fkpwolf/tinyFan/Schematic/tinyfan.sch

## EAGLE design Schematic/tinyfan.sch (2012-07-02)

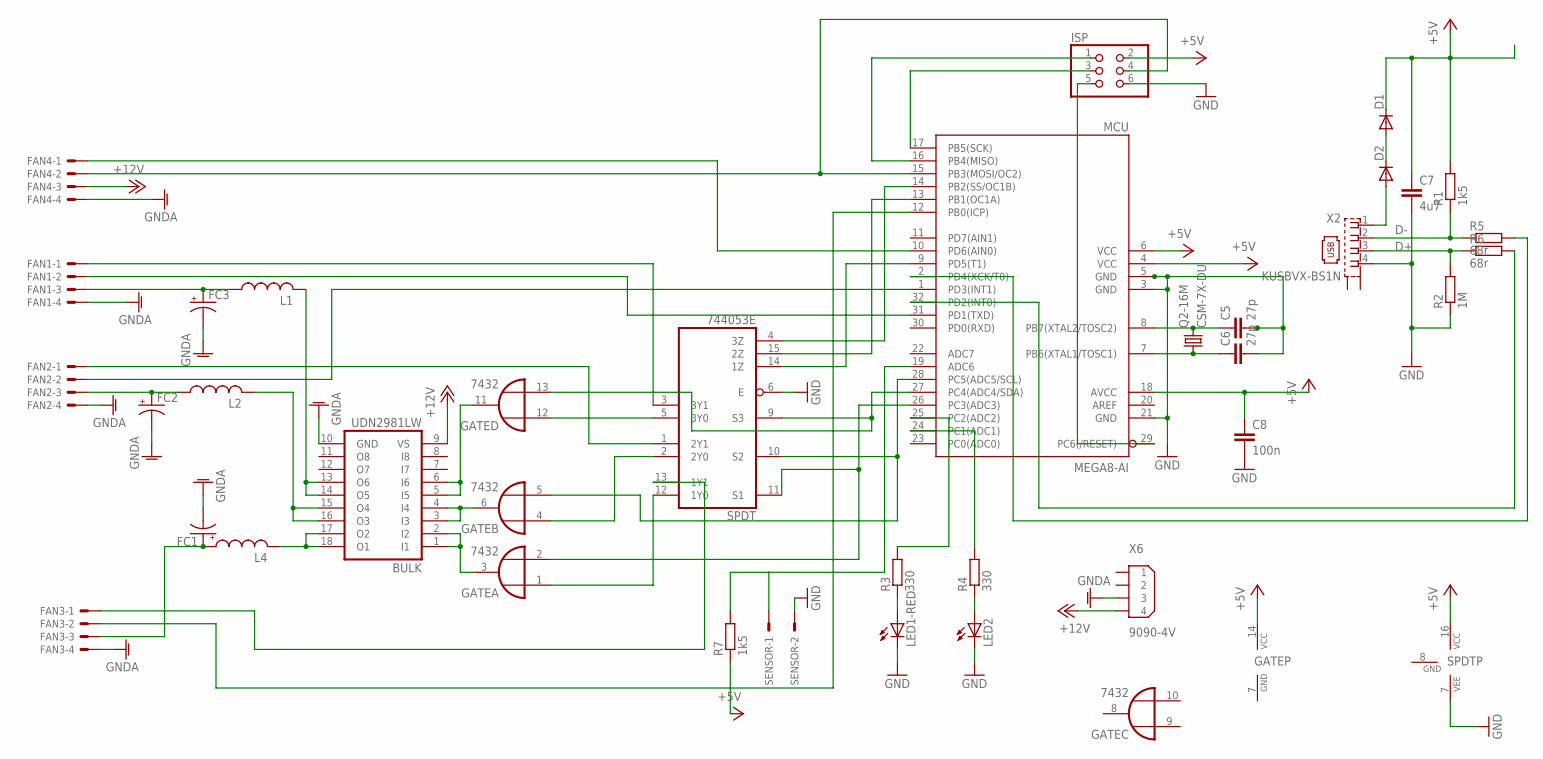
[picture p2: schematic tinyfan.sch]

Parts:
BULK: UDN2981LW; SO18W
C5, C6: 27p; C0805
C7: 4u7; C0805
C8: 100n; C0805
D1, D2: DIODE-MICROMELF-W; MICROMELF-W
FAN1, FAN2, FAN3: 22-23-2041; MPN 22-23-2041
FAN4: 22-23-2041
FC1, FC2, FC3: CPOL-US140CLH-1010; 140CLH-1010
GATE: 7432; TSSOP14
ISP: SMARTPRJ_PINHD-2X3; SMARTPRJ_2X03
L1, L2, L4: L-USL8080FAN; L5650M
LED1-RED, LED2: LEDSML0805; SML0805
MCU: MEGA8-AI; TQFP32-08
Q2-16M: CSM-7X-DU
R1, R7: 1k5; R0805
R2: 1M; R0805
R3, R4: 330; R0805
R5, R6: 68r; R0805
SENSOR: 22-23-2021
SPDT: 744053E; TSSOP16
X2: KUSBVX-BS1N
X6: 9090-4V

Connections:
+5V: C7.1, C8.1, D1.C, GATE.14 (VCC), ISP.2, MCU.4 (VCC), MCU.6 (VCC), MCU.18 (AVCC), R1.2, R7.1, SPDT.16 (VCC)
+12V: BULK.9 (VS), FAN4.3, X6.4
D+: R2.2, R6.1, X2.3
D-: R1.1, R5.1, X2.2
GND: C5.2, C6.2, C7.2, C8.2, ISP.6, LED1-RED.C, LED2.C, MCU.3 (GND), MCU.5 (GND), MCU.21 (GND), R2.1, SENSOR.2, SPDT.6 (E), SPDT.7 (VEE), X2.4
GNDA: BULK.10 (GND), FAN1.4, FAN2.4, FAN3.4, FAN4.4, FC1.-, FC2.-, FC3.-, X6.3
unnamed: D1.A, D2.C
unnamed: MCU.9 (PD5(T1)), SPDT.14 (1Z)
unnamed: FAN1.3, FC3.+, L1.1
unnamed: FAN4.1, MCU.10 (PD6(AIN0))
unnamed: MCU.2 (PD4(XCK/T0)), R5.2
unnamed: MCU.25 (PC2(ADC2)), R3.2
unnamed: ISP.3, MCU.17 (PB5(SCK))
unnamed: MCU.32 (PD2(INT0)), R6.2
unnamed: C6.1, MCU.7 (PB6(XTAL1/TOSC1)), Q2-16M.1
unnamed: C5.1, MCU.8 (PB7(XTAL2/TOSC2)), Q2-16M.2
unnamed: MCU.13 (PB1(OC1A)), SPDT.15 (2Z)
unnamed: MCU.14 (PB2(SS/OC1B)), SPDT.4 (3Z)
unnamed: FAN3.2, MCU.12 (PB0(ICP))
unnamed: FAN4.2, ISP.4, MCU.15 (PB3(MOSI/OC2))
unnamed: FAN2.2, MCU.1 (PD3(INT1))
unnamed: FAN1.2, MCU.31 (PD1(TXD))
unnamed: ISP.1, MCU.16 (PB4(MISO))
unnamed: LED1-RED.A, R3.1
unnamed: LED2.A, R4.1
unnamed: FAN2.3, FC2.+, L2.1
unnamed: D2.A, X2.1
unnamed: ISP.5, MCU.29 (PC6(/RESET))
unnamed: MCU.24 (PC1(ADC1)), R4.2
unnamed: GATE.2 (I1), MCU.26 (PC3(ADC3)), SPDT.11 (S1)
unnamed: FAN3.1, SPDT.13 (1Y1)
unnamed: BULK.1 (I1), BULK.2 (I2), GATE.3 (O)
unnamed: GATE.1 (I0), SPDT.12 (1Y0)
unnamed: BULK.17 (O2), BULK.18 (O1), L4.2
unnamed: BULK.13 (O6), BULK.14 (O5), L1.2
unnamed: FAN3.3, FC1.+, L4.1
unnamed: BULK.15 (O4), BULK.16 (O3), L2.2
unnamed: FAN2.1, SPDT.1 (2Y1)
unnamed: GATE.5 (I1), MCU.28 (PC5(ADC5/SCL)), SPDT.10 (S2)
unnamed: MCU.19 (ADC6), R7.2, SENSOR.1
unnamed: BULK.3 (I3), BULK.4 (I4), GATE.6 (O)
unnamed: GATE.4 (I0), SPDT.2 (2Y0)
unnamed: FAN1.1, SPDT.3 (3Y1)
unnamed: GATE.13 (I1), MCU.27 (PC4(ADC4/SDA)), SPDT.9 (S3)
unnamed: GATE.12 (I0), SPDT.5 (3Y0)
unnamed: BULK.5 (I5), BULK.6 (I6), GATE.11 (O)
