fkpwolf/tinyFan/(commit log)

2012-01-29 init Mac build environment
    and usb usbtiny, change name of usb device to tinyUSB. tired after
    chunjie.
2012-01-30 make the LED flash/second work again
    and remove pin-change interrupt code
2012-01-31 try to get fan speed
    now usb stable. but speed not correct. need to check denounce code
    [main.c]
2012-01-31 looks working now
    use 1:64 prescale. when no fan attached, reading value is fixed. but
    when attached, value changed and not stable.
    [main.c]
2012-02-01 add pull up resistor
    adopt new algorithm. it is clearer. but when no wire connected, value
    != 0. after add pull up resistor. value =0.
    Reading value is 0x10 when 1500rpm. should not be correct.
    [main.c]
2012-02-14 add PWM controling
    PWM is using time 1 of attiny45. Tach algorithm not changed. After
    using new clean power, tach value steady. 'hidtool write' not working
    fully
    [main.c]
2012-03-12 change to atmega48
    use new board, use bulk voltage.
    didn't finish Tach part's migration
    [main.c, usbconfig.h]
2012-03-24 change all pre scale of PWM to 1:1
    now some fan more stable
2012-03-25 fix error after upgrade avr-gcc(or avr-util)
    [main.c]
2012-05-04 add DPDT controller
    now can switch 3pin fan and 4pin fan using software
2012-05-04 first version of GUI controller
    now you can see Fan icon. but it is just a mockup
2012-05-06 UI part now works basiclly
    1) display tach. 2) control fan duty
2012-06-08 GUI client update
    now fan can be set to 3pin or 4pin, with icon!!!
2012-06-10 now set fan Pin mode works fully
    ya
2012-06-12 updates on Tinyfan UI
    1) device init with saved setting;
    2) when machine resume, re-init device
2012-07-02 schematic
    also found vusb has supported USB Version flag
    [tinyfan.sch]
2012-07-02 tiny fan UI client build zip
2012-09-13 support multipli device
    add serial number to USB description
2012-09-13 support multiply device
2012-09-21 client update(fan follow)
    follow to CPU or GPU
